philippe86220/Horloge-Nixie-ATmega328P/photos/IMG_4050.JPG

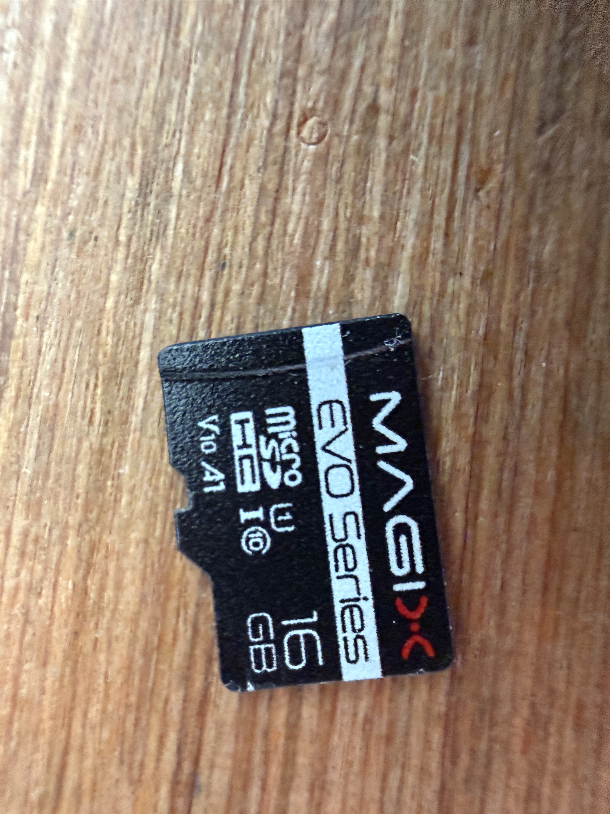
[picture p5: photos/IMG_4050.JPG]
photos/IMG_4050.JPG
